yyods/TitraLab/MicroPython/Week_2/02_Pump_Control/README.md

# 02_Pump_Control - การควบคุมและสอบเทียบปั๊ม
# Pump Control and Calibration

---

> **ส่วนนี้เป็นส่วนของ:** Week 2 - TitraLab MicroPython
> **เวลาที่ใช้:** 45 นาที

---

## สารบัญ (Table of Contents)

| หมวด | เนื้อหา |
|:----:|---|
| 1 | [วัตถุประสงค์](#วัตถุประสงค์-objectives) |
| 2 | [ความรู้พื้นฐาน](#ความรู้พื้นฐาน-prerequisites) |
| 3 | [หลักการทางเคมี](#หลักการทางเคมี-chemistry-principles) |
| 4 | [ไฟล์ในโฟลเดอร์](#ไฟล์ในโฟลเดอร์-files-in-this-folder) |
| 5 | [รายละเอียดไฟล์](#รายละเอียดไฟล์-file-details) |
| 6 | [เคล็ดลับการปฏิบัติ](#เคล็ดลับการปฏิบัติ-practical-tips) |
| 7 | [GPIO Configuration](#gpio-configuration) |
| 8 | [การเชื่อมต่อบทถัดไป](#การเชื่อมต่อกับบทเรียนถัดไป-next-steps) |

---

## วัตถุประสงค์ (Objectives)

เมื่อจบบทเรียนนี้ นิสิตจะสามารถ:

1. **เข้าใจความสำคัญของการสอบเทียบปั๊ม** ต่อความแม่นยำในการไทเทรต
2. **คำนวณ Flow Rate** จากปริมาตรและเวลา: `flow_rate = volume / time`
3. **ประเมินความสม่ำเสมอ** ด้วย %RSD (Relative Standard Deviation)
4. **บันทึกค่า Flow Rate** ลงไฟล์สำหรับใช้ในการไทเทรต

---

## ความรู้พื้นฐาน (Prerequisites)

### จาก Week 1 - ต่อยอดจาก `Week_1/core/07_PWM/`

| ไฟล์ใน Week 1 | ความรู้ที่ใช้ใน Week 2 |
|---|---|
| `01_pwm_led_brightness.py` | Duty Cycle พื้นฐาน (0-1023) |
| `02_pwm_led_fade.py` | การเปลี่ยน Duty Cycle |
| `04_pwm_pump_preview.py` | การควบคุมปั๊มเบื้องต้น |

**การเชื่อมโยง PWM กับการควบคุมปั๊ม:**
```
Duty Cycle (0-1023) --> ความเร็วปั๊ม --> อัตราการไหล (mL/s) --> ปริมาตรสารไทแทรนต์
```

### ทางเคมี:
- หลักการไทเทรตและความสำคัญของปริมาตรที่แม่นยำ
- การใช้กระบอกตวง (graduated cylinder)

---

## หลักการทางเคมี (Chemistry Principles)

### ทำไมต้องสอบเทียบปั๊ม?

ในการไทเทรตอัตโนมัติ ปริมาตรสารไทแทรนต์ต้องแม่นยำมาก:

| ผลกระทบ | รายละเอียด |
|---|---|
| ความผิดพลาด 0.1 mL | อาจทำให้คำนวณความเข้มข้นผิดพลาด 1-2% |
| Flow rate ไม่แน่นอน | หาจุดสมมูล (equivalence point) ได้ยาก |
| ปั๊มแต่ละตัว | มี flow rate ไม่เท่ากัน - ต้องสอบเทียบทุกครั้ง |

### สูตรคำนวณ

```
Flow Rate (mL/s) = ปริมาตรที่วัดได้ (mL) / เวลา (s)
```

**ตัวอย่าง:**
- ปั๊ม 15 วินาที ได้ปริมาตร 4.2 mL
- Flow Rate = 4.2 / 15 = 0.28 mL/s

### การประเมินความสม่ำเสมอด้วย %RSD

```
%RSD = (Standard Deviation / Average) x 100
```

| %RSD | ความหมาย | สถานะ |
|:----:|---|:-----:|
| < 2% | ดีเยี่ยม | ผ่าน |
| 2-5% | พอใช้ได้ | ผ่าน |
| >= 5% | ไม่สม่ำเสมอ | ต้องตรวจสอบ |

---

## ไฟล์ในโฟลเดอร์ (Files in This Folder)

| ไฟล์ | คำอธิบาย | ระดับความสำคัญ | เวลา |
|---|---|:---:|:----:|
| `01_flow_rate_calibration.py` | **การสอบเทียบ Flow Rate** - ไฟล์หลักที่ต้องทำ | **สำคัญมาก** | 20 นาที |
| `02_pump_validate_continuous.py` | การตรวจสอบความแม่นยำ: ปั๊มต่อเนื่อง | ตรวจสอบ | 10 นาที |
| `03_pump_validate_stepwise.py` | การตรวจสอบความแม่นยำ: ปั๊มเป็นช่วง | เสริม | 10 นาที |

---

## รายละเอียดไฟล์ (File Details)

### 01_flow_rate_calibration.py

**วัตถุประสงค์:** หาอัตราการไหลที่แท้จริงของปั๊ม

**สิ่งที่เรียนรู้:**
- การใช้ PWM ควบคุมปั๊ม
- การวัด Flow Rate จากปริมาตรและเวลา
- การคำนวณค่าเฉลี่ย, SD, และ %RSD
- การบันทึกค่าสอบเทียบ

**แนวคิดจาก Week 1 ที่ใช้:**
| แนวคิด | ไฟล์อ้างอิงใน Week 1 |
|---|---|
| PWM Duty Cycle | `Week_1/core/07_PWM/01_pwm_led_brightness.py` |
| การควบคุมปั๊ม | `Week_1/core/07_PWM/04_pwm_pump_preview.py` |

**ขั้นตอนการทำงาน:**

```
┌─────────────────────────────────────────────────────────────────┐
│  ขั้นตอนการสอบเทียบ Flow Rate (Flow Rate Calibration Steps)     │
└─────────────────────────────────────────────────────────────────┘

    ┌─────────────────────┐
    │ 1. เตรียมกระบอกตวง   │
    │    และบีกเกอร์น้ำ     │
    └──────────┬──────────┘
               │
               v
    ┌─────────────────────┐
    │ 2. กดปุ่ม 1 เริ่มปั๊ม │
    │    (จับเวลาอัตโนมัติ)  │
    └──────────┬──────────┘
               │
               v
    ┌─────────────────────┐
    │ 3. ปั๊ม 10-20 วินาที │
    └──────────┬──────────┘
               │
               v
    ┌─────────────────────┐
    │ 4. กดปุ่ม 1 หยุดปั๊ม │
    │    แสดงเวลาที่ใช้     │
    └──────────┬──────────┘
               │
               v
    ┌─────────────────────┐
    │ 5. อ่านปริมาตรจาก    │
    │    กระบอกตวง         │
    │    แก้ไข MEASURED_   │
    │    VOLUME ในโค้ด     │
    └──────────┬──────────┘
               │
               v
    ┌─────────────────────┐
    │ 6. กดปุ่ม 2 บันทึก   │
    │    (ทำซ้ำ 3-5 ครั้ง)  │
    └──────────┬──────────┘
               │
               v
    ┌─────────────────────┐
    │ 7. กดปุ่ม 3 บันทึก   │
    │    ลงไฟล์            │
    │ flow_calibration.txt│
    └─────────────────────┘
```

**การควบคุมปุ่ม:**

| ปุ่ม | GPIO | การทำงาน |
|:----:|:----:|---|
| 1 | 34 | เริ่ม/หยุดปั๊ม |
| 2 | 35 | บันทึกปริมาตรที่วัดได้ |
| 3 | 39 | บันทึกลงไฟล์ |

**ผลลัพธ์:**
- ไฟล์ `/workspace/data/flow_calibration.txt` ที่มีค่า flow rate เฉลี่ย (mL/s)

**เกณฑ์ความสำเร็จ:**
- %RSD < 5%

**โค้ดสำคัญ - การคำนวณ Flow Rate และ %RSD:**

```python
def record_measurement():
    """
    บันทึกผลการวัดและคำนวณ flow rate
    สูตร: flow_rate = volume / time (mL/s)
    """
    global calibration_data, current_volume

    # ใช้ค่าจากตัวแปร MEASURED_VOLUME
    current_volume = MEASURED_VOLUME

    # คำนวณ flow rate
    flow_rate = current_volume / elapsed_time

    # บันทึกข้อมูล
    calibration_data.append((elapsed_time, current_volume, flow_rate))

    # คำนวณค่าเฉลี่ยและ RSD
    if len(calibration_data) >= 2:
        avg_flow_rate = sum(d[2] for d in calibration_data) / len(calibration_data)
        variance = sum((d[2] - avg_flow_rate) ** 2 for d in calibration_data) / len(calibration_data)
        std_dev = variance ** 0.5
        rsd = (std_dev / avg_flow_rate) * 100  # %RSD

        if rsd > 5:
            print("*** คำเตือน: RSD > 5% - ค่าไม่สม่ำเสมอ ***")
```

---

### 02_pump_validate_continuous.py

**วัตถุประสงค์:** ตรวจสอบความแม่นยำของการสอบเทียบด้วยการปั๊มต่อเนื่อง

**การใช้งาน:**
- ตั้งปริมาตรเป้าหมาย (เช่น 5 mL)
- ปั๊มจะหยุดเมื่อถึงปริมาตรที่ตั้งไว้
- วัดปริมาตรจริงจากกระบอกตวง
- เปรียบเทียบค่าที่วัดได้กับค่าที่ตั้งไว้

**การประยุกต์ใช้:**
- ใช้ในช่วงเริ่มต้นการไทเทรต (pH ยังห่างจากจุดสมมูล)

**เกณฑ์ความสำเร็จ:**
- % error < 5%

---

### 03_pump_validate_stepwise.py

**วัตถุประสงค์:** ตรวจสอบการปั๊มแบบเป็นช่วง (stepwise)

**การใช้งาน:**
- ปั๊มทีละ 0.1-0.5 mL
- หยุดรอให้ pH เสถียร
- ปั๊มต่อ

**การประยุกต์ใช้:**
- ใช้ในช่วงใกล้จุดสมมูล (equivalence point)
- ป้องกันการ overshoot จุดสมมูล

---

## เคล็ดลับการปฏิบัติ (Practical Tips)

### การเตรียมอุปกรณ์

1. ใช้กระบอกตวงที่มีความละเอียด 0.1 mL หรือดีกว่า
2. ตรวจสอบว่าท่อปั๊มไม่มีฟองอากาศ (purge ก่อนสอบเทียบ)
3. วางกระบอกตวงให้ตั้งตรง

### การวัด Flow Rate

1. ทำซ้ำ 3-5 ครั้งเพื่อหาค่าเฉลี่ย
2. ปั๊มครั้งละ 10-20 วินาทีเพื่อให้ได้ปริมาตรที่วัดง่าย
3. อ่านกระบอกตวงที่ระดับสายตา (meniscus)

### การแก้ไขเมื่อ %RSD >= 5%

| สาเหตุที่เป็นไปได้ | วิธีแก้ไข |
|---|---|
| ฟองอากาศในท่อ | Purge ท่อ (ปั๊มจนไม่มีฟอง) |
| ท่อหลวม | ตรวจสอบการเชื่อมต่อท่อ |
| แหล่งจ่ายไฟไม่เสถียร | ใช้แหล่งจ่ายไฟคุณภาพดี |
| จำนวนครั้งน้อย | เพิ่มจำนวนครั้งในการวัด |

---

## GPIO Configuration

| อุปกรณ์ | GPIO | ค่าคงที่ | ประเภท | หมายเหตุ |
|---|:----:|---|---|---|
| Pump | 21 | `PUMP_PIN` | PWM Output | freq=1000 Hz |
| Red LED (ปั๊มทำงาน) | 2 | `LED_RED` | Output | แสดงสถานะปั๊ม |
| Green LED (บันทึกสำเร็จ) | 4 | `LED_GREEN` | Output | แสดงการบันทึก |
| Button 1 (Start/Stop) | 34 | `BUTTON1` | Input-only | External pull-down |
| Button 2 (Record) | 35 | `BUTTON2` | Input-only | External pull-down |
| Button 3 (Save) | 39 | `BUTTON3` | Input-only | External pull-down |

### PWM Settings

```python
# ความถี่ 1000 Hz, Duty Cycle 10-bit (0-1023)
pump_pwm = PWM(Pin(21), freq=1000)
pump_pwm.duty(1023)  # Full speed
pump_pwm.duty(0)     # Stop
```

**การเชื่อมโยง Duty Cycle กับ Flow Rate:**

| Duty Cycle | ค่า | ความเร็วปั๊ม |
|:---:|:---:|:---:|
| 100% | 1023 | เต็มกำลัง |
| 50% | 511 | ครึ่งกำลัง |
| 0% | 0 | หยุด |

---

## การเชื่อมต่อกับบทเรียนถัดไป (Next Steps)

เมื่อสอบเทียบปั๊มสำเร็จแล้ว:

```
  ┌─────────────────────┐
  │ 01_pH_Sensor/       │
  │ (เสร็จแล้ว)          │ --> ph_calibration.txt
  └──────────┬──────────┘
             │
             v
  ┌─────────────────────┐
  │ 02_Pump_Control/    │     ไฟล์ที่ได้:
  │ (ปัจจุบัน)           │ --> flow_calibration.txt
  └──────────┬──────────┘
             │
             v
  ┌─────────────────────┐
  │ 03_OOP_Advanced/    │     เรียนรู้ OOP:
  │ (ถัดไปใน Week 2)    │     Inheritance,
  │                     │     Composition
  └──────────┬──────────┘
             │
             v
  ┌─────────────────────┐
  │ Week_3/             │     ใช้ค่าจากทั้งสองไฟล์
  │ ระบบไทเทรตอัตโนมัติ  │     ในการไทเทรตจริง
  └─────────────────────┘
```

1. **Week 2 ต่อ:** ไปที่ `../03_OOP_Advanced/` เพื่อเรียนรู้ OOP Concepts
2. **Week 3:** ใช้ค่าจาก `/workspace/data/flow_calibration.txt` ในระบบไทเทรตอัตโนมัติ

---

*สร้างเมื่อ: มกราคม 2026*
