yyods/TitraLab/MicroPython/Week_2/01_pH_Sensor/README.md

# 01_pH_Sensor - การวัดและสอบเทียบ pH
# pH Measurement and Calibration

---

> **ส่วนนี้เป็นส่วนของ:** Week 2 - TitraLab MicroPython
> **เวลาที่ใช้:** 60 นาที (1 ชั่วโมง)

---

## สารบัญ (Table of Contents)

| หมวด | เนื้อหา |
|:----:|---|
| 1 | [วัตถุประสงค์](#วัตถุประสงค์-objectives) |
| 2 | [ความรู้พื้นฐาน](#ความรู้พื้นฐาน-prerequisites) |
| 3 | [หลักการทางเคมี](#หลักการทางเคมี-chemistry-principles) |
| 4 | [ไฟล์ในโฟลเดอร์](#ไฟล์ในโฟลเดอร์-files-in-this-folder) |
| 5 | [รายละเอียดไฟล์](#รายละเอียดไฟล์-file-details) |
| 6 | [เคล็ดลับการปฏิบัติ](#เคล็ดลับการปฏิบัติ-practical-tips) |
| 7 | [GPIO Configuration](#gpio-configuration) |
| 8 | [การเชื่อมต่อบทถัดไป](#การเชื่อมต่อกับบทเรียนถัดไป-next-steps) |

---

## วัตถุประสงค์ (Objectives)

เมื่อจบบทเรียนนี้ นิสิตจะสามารถ:

1. **ทดสอบเวลาตอบสนองของหัววัด pH** (Response Time) โดยบันทึกค่า mV เมื่อย้ายระหว่างบัฟเฟอร์
2. **เข้าใจสมการ Nernst** และการแปลงค่า mV เป็น pH
3. **ทำการสอบเทียบ 3 จุด** ด้วยสารละลายบัฟเฟอร์มาตรฐาน (pH 4, 7, 10)
4. **คำนวณ Linear Regression ด้วยตัวเอง** จากข้อมูลดิบก่อนตรวจสอบกับโปรแกรม
5. **ประเมินคุณภาพการสอบเทียบ** ด้วย R-squared และ Slope Efficiency
6. **บันทึกค่าสอบเทียบ** ลงไฟล์สำหรับใช้ในการไทเทรต

---

## ความรู้พื้นฐาน (Prerequisites)

### จาก Week 1 - ต่อยอดจาก `Week_1/core/07_ADC/`

| ไฟล์ใน Week 1 | ความรู้ที่ใช้ใน Week 2 |
|---|---|
| `01_adc_basics.py` | การอ่านค่า ADC 12-bit (0-4095) |
| `02_adc_averaging.py` | การหาค่าเฉลี่ยเพื่อลด noise |
| `03_adc_attenuation.py` | การตั้งค่า ATTN_11DB สำหรับ 0-3.3V |

**การเชื่อมโยง ADC กับการวัด pH:**
```
หัววัด pH (mV) --> ADC (0-4095) --> แปลงเป็น mV --> สมการ Nernst --> ค่า pH
```

### ทางเคมี:
- หลักการทำงานของหัววัด pH (pH electrode)
- สมการ Nernst: E = E0 - (2.303RT/nF) x pH

---

## หลักการทางเคมี (Chemistry Principles)

### สมการ Nernst

หัววัด pH ให้สัญญาณแรงดันไฟฟ้า (mV) ตามสมการ:

```
E = E0 - (2.303RT/nF) x pH
```

จัดรูปใหม่เป็นสมการเส้นตรง:

```
E (mV) = m x pH + b
```

| ตัวแปร | ความหมาย | ค่าทฤษฎีที่ 25C |
|---|---|---|
| m (slope) | ความชัน | -59.16 mV/pH |
| b (intercept) | ศักย์ไฟฟ้าที่ pH=0 | ขึ้นกับหัววัด |

### ความชัน Nernst ที่อุณหภูมิต่างๆ

| อุณหภูมิ (C) | อุณหภูมิ (K) | ความชันทฤษฎี (mV/pH) |
|:---:|:---:|:---:|
| 20 | 293.15 | -58.17 |
| **25** | **298.15** | **-59.16** |
| 30 | 303.15 | -60.15 |

### การสอบเทียบ 3 จุด

| สารละลายบัฟเฟอร์ | ค่า pH | ความสำคัญ |
|:---:|:---:|---|
| Potassium hydrogen phthalate | 4.00 | ตัวแทนช่วงกรด (acidic range) |
| Phosphate buffer | 7.00 | จุด isopotential - ไม่ขึ้นกับอุณหภูมิ |
| Carbonate-bicarbonate buffer | 10.00 | ตัวแทนช่วงเบส (basic range) |

---

## ไฟล์ในโฟลเดอร์ (Files in This Folder)

| ไฟล์ | คำอธิบาย | ระดับความสำคัญ | เวลา |
|---|---|:---:|:----:|
| `01_basic_ph_read.py` | **ทดสอบ Response Time** - บันทึก mV ทุกวินาทีเป็นเวลา 45 วินาที | ทำความเข้าใจ | 15-20 นาที |
| `02_calibration_3point.py` | **การสอบเทียบ pH 3 จุด** - ไฟล์หลักที่ต้องทำ พร้อมแสดงข้อมูลดิบสำหรับคำนวณเอง | **สำคัญมาก** | 40 นาที |

---

## รายละเอียดไฟล์ (File Details)

### 01_basic_ph_read.py

**วัตถุประสงค์:** ทดสอบเวลาตอบสนอง (Response Time) ของหัววัด pH

**การทดลอง:**
1. แช่หัววัด pH ในสารละลายบัฟเฟอร์
2. กดปุ่มเพื่อเริ่มบันทึก
3. โปรแกรมจะบันทึกค่า mV ทุก 1 วินาที เป็นเวลา 45 วินาที
4. นำข้อมูลไปวิเคราะห์ดูว่าหัววัดเสถียรที่เวลาเท่าไร

**สิ่งที่เรียนรู้:**
- การใช้ ADC อ่านค่าจากหัววัด pH (GPIO32)
- การอ่านอุณหภูมิจาก DS18B20 (GPIO16)
- การแปลงค่า ADC เป็น mV: `voltage_mv = adc_value * 3300 / 4095`
- วงจร op-amp (LMC6482) ชดเชย offset +1650 mV
- การแสดงผลบนจอ TFT

**แนวคิดจาก Week 1 ที่ใช้:**
| แนวคิด | ไฟล์อ้างอิงใน Week 1 |
|---|---|
| ADC 12-bit | `Week_1/core/07_ADC/01_adc_basics.py` |
| การหาค่าเฉลี่ย | `Week_1/core/07_ADC/02_adc_averaging.py` |
| TFT Display | `Week_1/05_TFT/` |

---

### 02_calibration_3point.py

**วัตถุประสงค์:** สอบเทียบหัววัด pH ด้วยสารละลายบัฟเฟอร์มาตรฐาน 3 จุด

**สิ่งที่เรียนรู้:**
- การสอบเทียบ 3 จุด (3-point calibration)
- การคำนวณ Linear Regression ด้วยตัวเอง (ก่อนตรวจสอบกับโปรแกรม)
- การประเมิน R-squared และ Slope Efficiency
- การบันทึกค่าสอบเทียบ

**คุณสมบัติใหม่ - แสดงข้อมูลดิบสำหรับคำนวณเอง:**

หลังจากสอบเทียบครบ 3 จุด โปรแกรมจะแสดงตารางข้อมูลดิบ:
```
╔══════════════════════════════════════════════════╗
║     RAW CALIBRATION DATA FOR MANUAL CALCULATION  ║
║     ข้อมูลดิบสำหรับคำนวณด้วยตนเอง                  ║
╠══════════════════════════════════════════════════╣
║  Point  │  pH (x)  │   mV (y)   │  Temp (°C)    ║
║─────────┼──────────┼────────────┼───────────────║
║    1    │   4.00   │  1827.5    │    25.2       ║
║    2    │   7.00   │  1650.3    │    25.1       ║
║    3    │  10.00   │  1473.1    │    25.3       ║
╚══════════════════════════════════════════════════╝
```

พร้อมแสดงสูตรสำหรับการคำนวณ Linear Regression:
- slope (m) = (n·Σxy - Σx·Σy) / (n·Σx² - (Σx)²)
- intercept (b) = (Σy - m·Σx) / n
- R² = 1 - SS_res/SS_tot

นิสิตจะมีเวลาคำนวณด้วยตัวเองก่อนกดปุ่มดูคำตอบจากโปรแกรม

**ขั้นตอนการทำงาน:**

```
┌─────────────────────────────────────────────────────────────────┐
│  ขั้นตอนการสอบเทียบ pH 3 จุด (3-Point pH Calibration Steps)    │
└─────────────────────────────────────────────────────────────────┘

    ┌─────────────────────┐
    │ 1. แช่ใน pH 4.00    │
    │    รอเสถียร 30-60s   │
    │    กดปุ่มบันทึก       │
    └──────────┬──────────┘
               │
               v
    ┌─────────────────────┐
    │ 2. ล้างหัววัด        │
    │    แช่ใน pH 7.00    │
    │    รอเสถียร 30-60s   │
    │    กดปุ่มบันทึก       │
    └──────────┬──────────┘
               │
               v
    ┌─────────────────────┐
    │ 3. ล้างหัววัด        │
    │    แช่ใน pH 10.00   │
    │    รอเสถียร 30-60s   │
    │    กดปุ่มบันทึก       │
    └──────────┬──────────┘
               │
               v
    ┌─────────────────────┐
    │ 4. คำนวณ Linear     │
    │    Regression       │
    │    แสดงผล R^2       │
    └──────────┬──────────┘
               │
               v
    ┌─────────────────────┐
    │ 5. บันทึกไฟล์        │
    │    ph_calibration   │
    │    .txt             │
    └─────────────────────┘
```

**ผลลัพธ์:**
- ไฟล์ `/workspace/data/ph_calibration.txt` ที่มี slope, intercept, R-squared, อุณหภูมิ
- ไฟล์ `calibration_log.txt` รายละเอียดการสอบเทียบ

**เกณฑ์ความสำเร็จ:**

| ตัวชี้วัด | ดีเยี่ยม | พอใช้ได้ | ต้องทำใหม่ |
|---|:---:|:---:|:---:|
| R-squared | >= 0.999 | >= 0.99 | < 0.99 |
| Slope Efficiency | 95-105% | 90-110% | นอกช่วงนี้ |

**โค้ดสำคัญ - การคำนวณ Linear Regression:**

```python
def linear_regression(x_values, y_values):
    """
    คำนวณการถดถอยเชิงเส้น y = mx + b พร้อมค่า R-squared
    สำหรับเซ็นเซอร์ pH: E(mV) = m * pH + b
    """
    n = len(x_values)

    # คำนวณค่าที่ต้องใช้ (Calculate required sums)
    sum_x = sum(x_values)
    sum_y = sum(y_values)
    sum_xy = sum(x * y for x, y in zip(x_values, y_values))
    sum_x2 = sum(x ** 2 for x in x_values)

    # คำนวณความชัน (Calculate slope)
    denominator = n * sum_x2 - sum_x ** 2
    slope = (n * sum_xy - sum_x * sum_y) / denominator

    # คำนวณจุดตัดแกน y (Calculate intercept)
    intercept = (sum_y - slope * sum_x) / n

    # คำนวณ R-squared
    y_mean = sum_y / n
    ss_tot = sum((y - y_mean) ** 2 for y in y_values)
    ss_res = sum((y - (slope * x + intercept)) ** 2
                 for x, y in zip(x_values, y_values))
    r_squared = 1 - (ss_res / ss_tot)

    return slope, intercept, r_squared
```

---

## เคล็ดลับการปฏิบัติ (Practical Tips)

### การเตรียมสารละลายบัฟเฟอร์

1. ใช้สารละลายบัฟเฟอร์มาตรฐานที่ยังไม่หมดอายุ
2. เก็บรักษาในภาชนะที่ปิดสนิท ห่างจากความร้อนและแสง
3. ตรวจสอบอุณหภูมิของสารละลายบัฟเฟอร์

### การล้างหัววัด

1. ล้างด้วยน้ำกลั่น (deionized water) ระหว่างเปลี่ยนบัฟเฟอร์
2. ซับน้ำเบาๆ ด้วยกระดาษทิชชู่ - ห้ามถูแรง
3. ไม่ควรปล่อยให้หัววัดแห้ง

### เวลารอให้ค่าเสถียร (Stabilization Time)

- รอ 30-60 วินาทีหลังจากแช่หัววัดในบัฟเฟอร์
- ค่าควรเปลี่ยนแปลงน้อยกว่า 1 mV/นาที ก่อนกดบันทึก

### การแก้ไขเมื่อ R-squared < 0.99

| สาเหตุที่เป็นไปได้ | วิธีแก้ไข |
|---|---|
| สารละลายบัฟเฟอร์เสื่อมสภาพ | ใช้บัฟเฟอร์ใหม่ |
| หัววัดสกปรก | ทำความสะอาดหัววัด |
| สายสัญญาณหลวม | ตรวจสอบการเชื่อมต่อ |
| ไม่รอให้เสถียร | รอนานขึ้นก่อนกดบันทึก |

---

## GPIO Configuration

| อุปกรณ์ | GPIO | ค่าคงที่ | ประเภท | หมายเหตุ |
|---|:----:|---|---|---|
| pH Sensor | 32 | `MY_PH_PIN` | ADC Input (ADC1) | ATTN_11DB (0-3.3V), ใช้ได้กับ WiFi |
| Temperature (DS18B20) | 16 | `MY_TEMP_PIN` | OneWire | ต้องใช้ pull-up 4.7K |
| Button 1 (บันทึก) | 34 | `MY_BUTTON_PIN` | Input-only | ต้องใช้ external pull-down |
| TFT Display | SPI1 | - | SPI | GPIO14 SCK, GPIO13 MOSI |

---

## การเชื่อมต่อกับบทเรียนถัดไป (Next Steps)

เมื่อสอบเทียบ pH สำเร็จแล้ว:

```
  ┌─────────────────────┐
  │ 01_pH_Sensor/       │     ไฟล์ที่ได้:
  │ (ปัจจุบัน)           │ --> ph_calibration.txt
  └──────────┬──────────┘
             │
             v
  ┌─────────────────────┐
  │ 02_Pump_Control/    │     สอบเทียบ Flow Rate
  │ (ถัดไปใน Week 2)    │ --> flow_calibration.txt
  └──────────┬──────────┘
             │
             v
  ┌─────────────────────┐
  │ Week_3/             │     ใช้ค่าจากทั้งสองไฟล์
  │ ระบบไทเทรตอัตโนมัติ  │     ในการไทเทรตจริง
  └─────────────────────┘
```

1. **Week 2 ต่อ:** ไปที่ `../02_Pump_Control/` เพื่อสอบเทียบปั๊ม
2. **Week 3:** ใช้ค่าจาก `/workspace/data/ph_calibration.txt` ในระบบไทเทรตอัตโนมัติ

---

*สร้างเมื่อ: มกราคม 2026*
