yyods/TitraLab/imgs/1.png

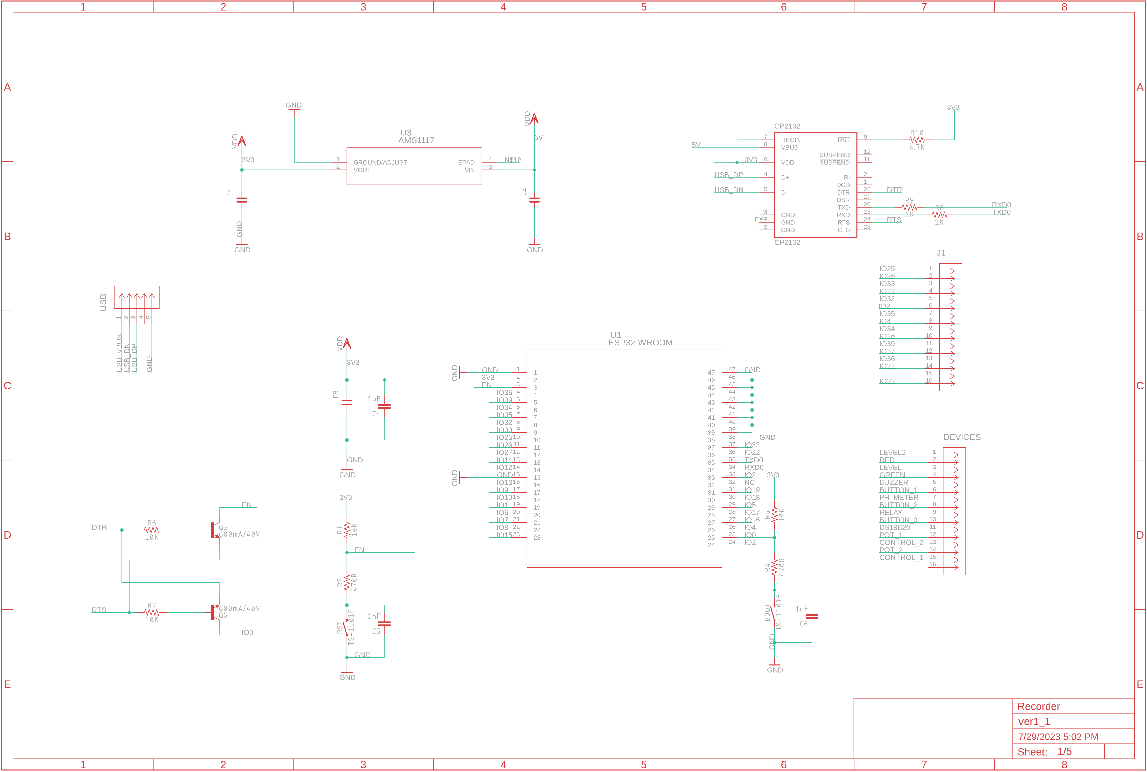
imgs/1.png
