yyods/TitraLab/imgs/2.png

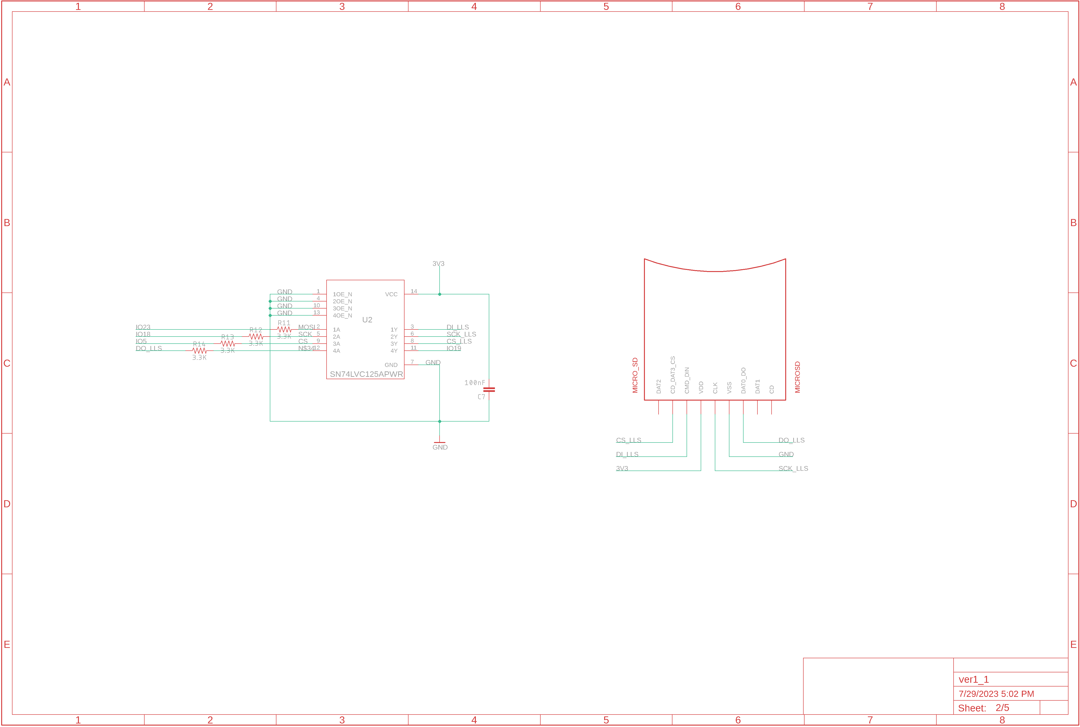
imgs/2.png
