yyods/TitraLab/imgs/3.png

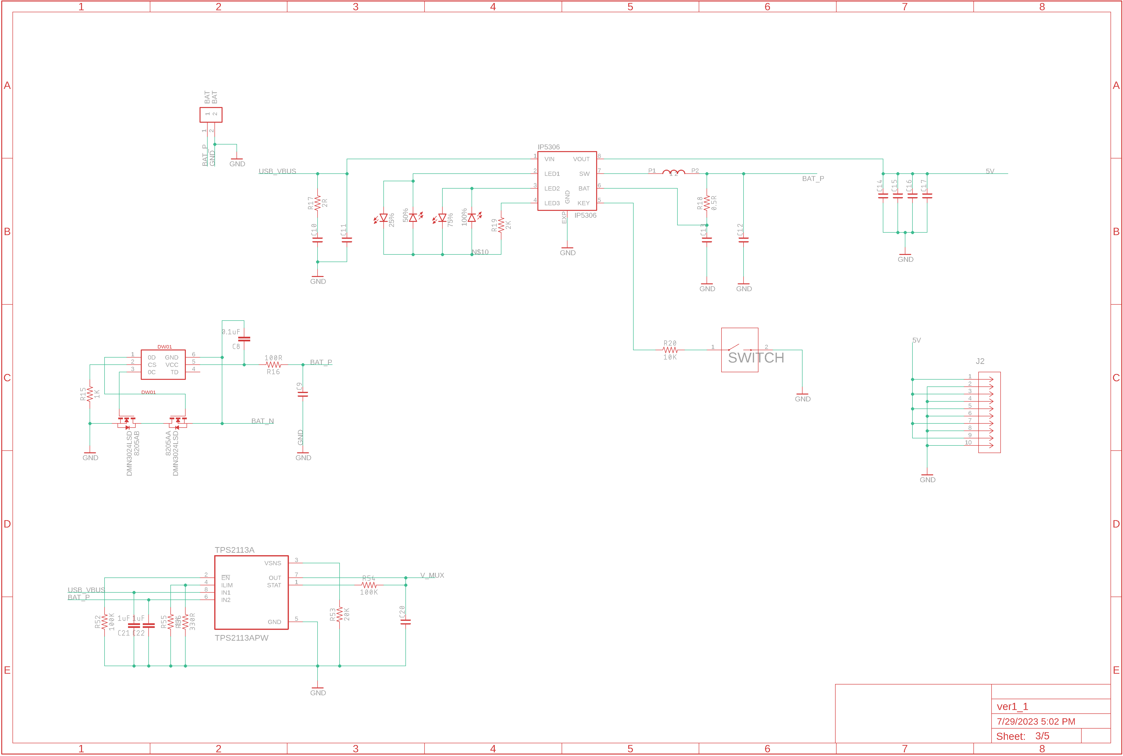
imgs/3.png
