yyods/TitraLab/imgs/4.png

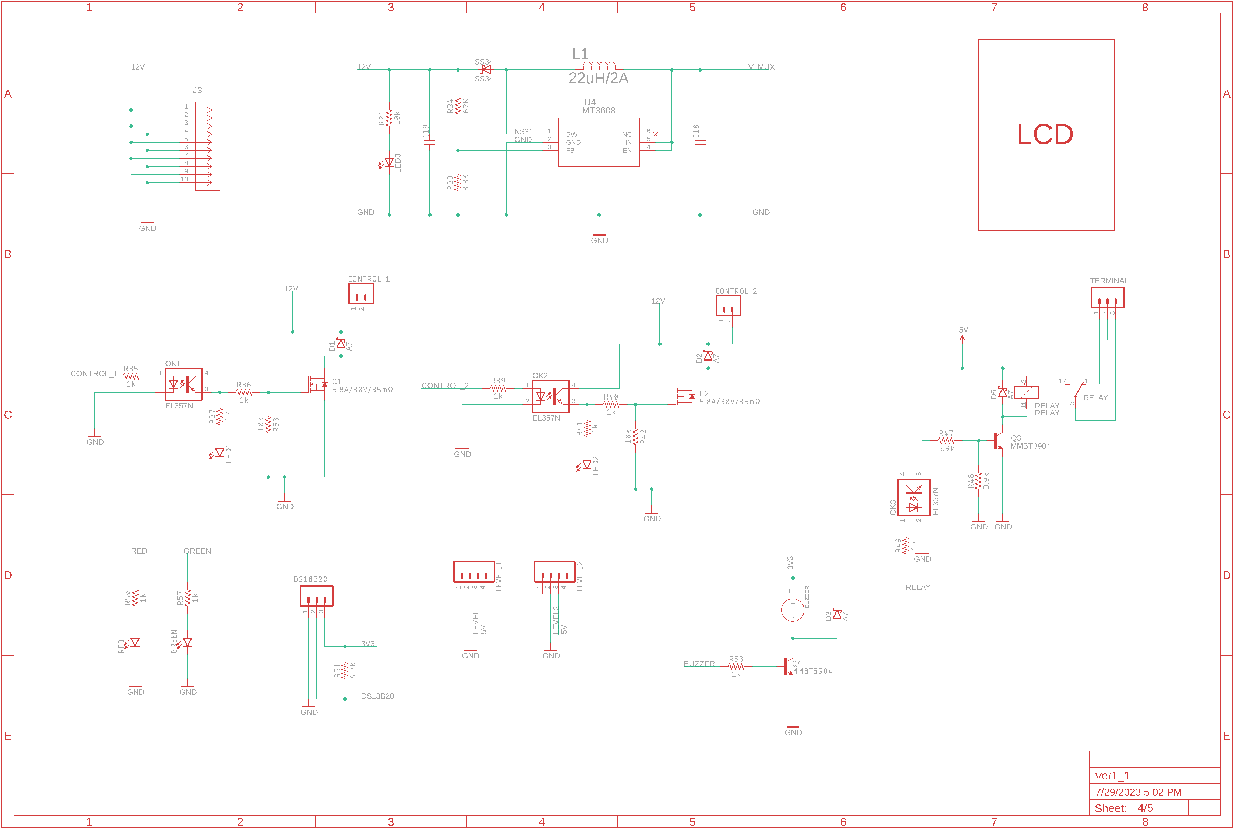
imgs/4.png
