yyods/TitraLab/imgs/5.png

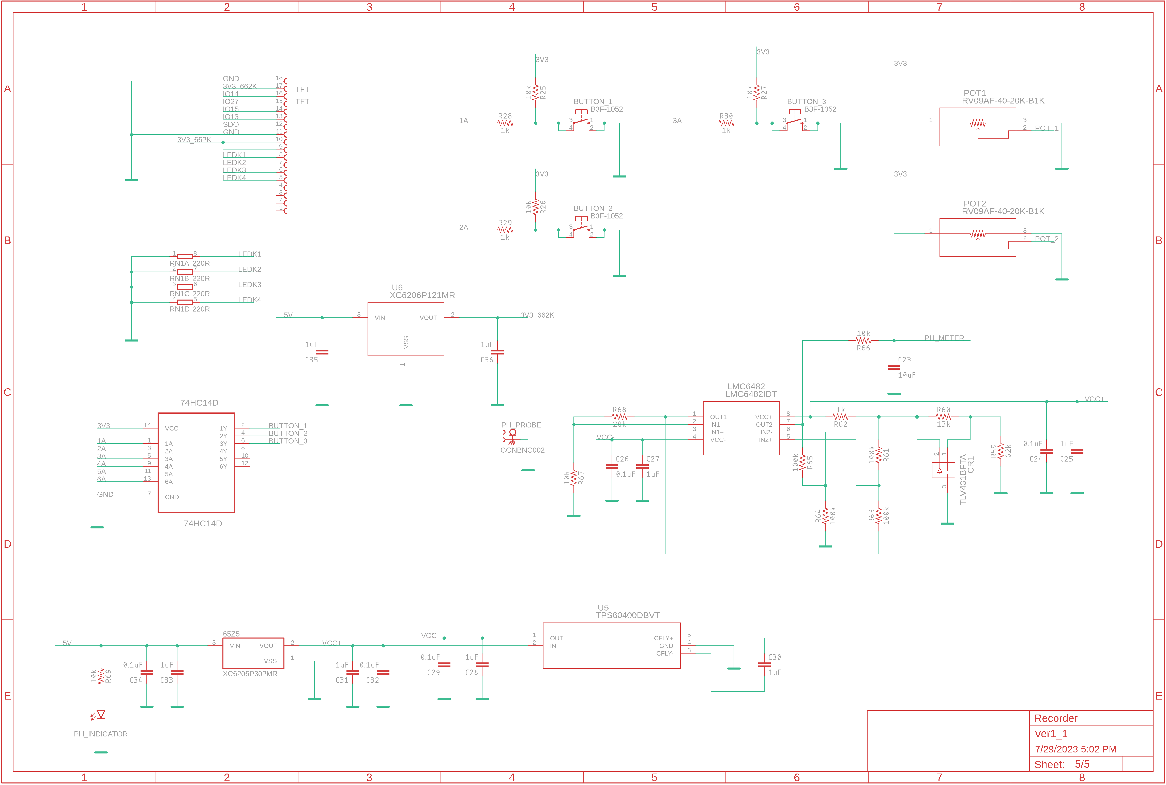
imgs/5.png
