yyods/TitraLab/imgs/ver1_1_Bottom.png

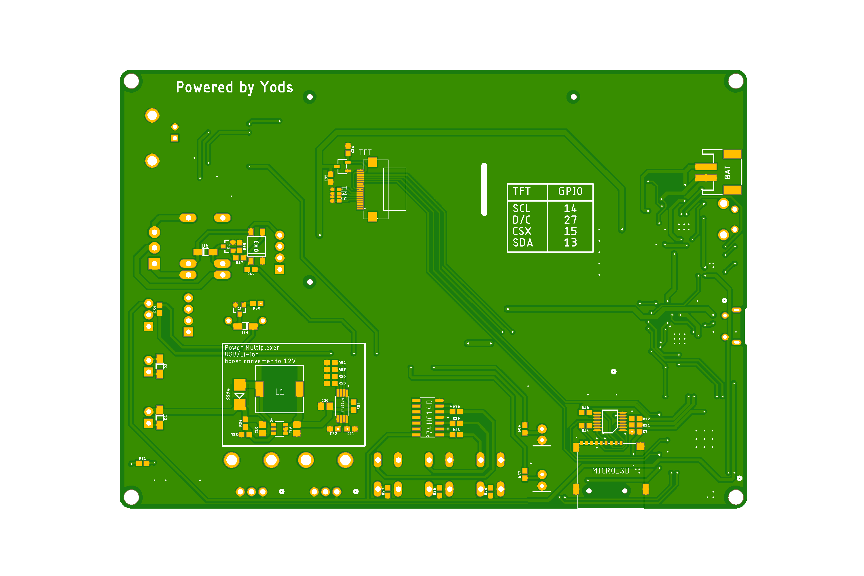
imgs/ver1_1_Bottom.png
