yyods/TitraLab/EquivPoint/test_wrong_columns.csv

Volume | pH
1.0 | 7.0
