yyods/TitraLab/MicroPython/Week_2/02_Pump_Control/04_flow_stepwise_finetune.py

# ==============================================================================
# 04_flow_stepwise_finetune.py - ปรับละเอียดอัตราการไหลแบบ stop-flow
# Stepwise (stop-flow) fine-tune for the pump calibration
# ==============================================================================
# ทำไมต้องมีขั้นนี้ (Why this stage exists):
#   การสอบเทียบใน 01_flow_rate_calibration.py วัดอัตราการไหลแบบ "ไหลต่อเนื่อง"
#   แต่การไทเทรตจริง (Week_3) หยดแบบ "หยุด-ไหล" (stop-flow) เป็นช่วงสั้น ๆ
#   ทุกครั้งที่ปั๊มสตาร์ท จะมีช่วง "เสียเปล่า" (มอเตอร์หมุนขึ้น, ท่อยืดหยุ่น,
#   soft-start ของเฟิร์มแวร์) ทำให้แต่ละหยดจ่ายน้อยกว่าที่คำนวณ — สะสมทั้งการ
#   ไทเทรตอาจคลาดถึง ~0.4 mL ซึ่งยอมรับไม่ได้ในเคมีวิเคราะห์
#
#   Continuous calibration amortizes the START-UP DEFICIT (motor spin-up,
#   tubing elasticity, firmware soft-start) over one long run. Stop-flow
#   dosing pays that deficit ON EVERY BURST. This lesson MEASURES it:
#
#       V(t_on) = flow_ss x t_on - V_deficit          (two-parameter pump model)
#
#   ขั้นตอน: หยด N ครั้งด้วยโปรไฟล์เดียวกับการไทเทรตจริง -> นิสิตอ่านปริมาตร
#   จริงจากกระบอกตวง -> คำนวณ V_deficit ต่อหยด -> บันทึกเพิ่มในไฟล์สอบเทียบ
#   (burst_deficit_ml) — Week_3 จะชดเชยเวลาเปิดปั๊มให้อัตโนมัติ
#
# ลำดับบทเรียน (Lesson order):
#   01_flow_rate_calibration.py  -> flow_rate (ไหลต่อเนื่อง)
#   04_flow_stepwise_finetune.py -> burst_deficit_ml (ไฟล์นี้)
#   03_pump_validate_stepwise.py -> ตรวจสอบว่า stop-flow ตรงเป้าแล้ว
#
# สำคัญ: บทเรียนนี้ขับปั๊มผ่าน slp.set_actuator (เส้นทางเดียวกับการไทเทรต
# Week_3 รวม soft-start ของเฟิร์มแวร์) — ไม่ใช่ PWM ตรงแบบ 01/02/03 — เพื่อวัด
# ช่วงเสียเปล่าของ "ระบอบการทำงานจริง" (calibrate in the regime you operate!)
# ต่อแบตเตอรี่ก่อนใช้ปั๊มเสมอ (Battery required for the pump.)
# ==============================================================================

import time

import scilabpro as slp

# ==============================================================================
# ค่าคงที่ (Constants)
# ==============================================================================
CAL_PATH = '/workspace/data/flow_calibration.txt'
PUMP_ENDPOINT = 'CONTROL_1'
DOSE_VOLUME_ML = 0.2      # ปริมาตรต่อหยดเหมือน Week_3 (same as the titration)
N_BURSTS = 25             # จำนวนหยด -> คาดหวังรวม 5.0 mL (expected 5.0 mL)
PAUSE_MS = 1500           # หยุดระหว่างหยด (pause between bursts)
MAX_ON_MS = 1800          # เพดานความปลอดภัยต่อหยด (per-burst safety ceiling)


def load_flow_rate():
    """อ่าน flow_rate จากไฟล์สอบเทียบขั้นที่ 1 (ต้องทำ 01 ก่อน)."""
    try:
        with open(CAL_PATH, 'r') as f:
            for line in f:
                line = line.strip()
                if line.startswith('flow_rate='):
                    return float(line.split('=')[1])
    except OSError:
        pass
    return None


def save_deficit(flow_rate, deficit_ml, dead_time_ms):
    """เขียน burst_deficit_ml เพิ่มในไฟล์สอบเทียบ (คงค่า flow_rate เดิมไว้).

    รูปแบบไฟล์ยังเข้ากันได้ย้อนหลัง: ผู้อ่านเดิมที่รู้จักแค่ flow_rate=
    ยังใช้งานได้ (additive key, backward compatible).
    """
    lines = []
    try:
        with open(CAL_PATH, 'r') as f:
            for line in f:
                # ตัดค่า deficit เก่าออก (จะเขียนใหม่ด้านล่าง)
                if not line.strip().startswith('burst_deficit_ml='):
                    lines.append(line.rstrip('\n'))
    except OSError:
        lines = [f'flow_rate={flow_rate:.4f}']
    lines.append('# stop-flow fine-tune (04): per-burst start-up deficit')
    lines.append(f'# dead_time ~ {dead_time_ms:.0f} ms/burst at this flow rate')
    lines.append(f'burst_deficit_ml={deficit_ml:.4f}')
    with open(CAL_PATH, 'w') as f:
        f.write('\n'.join(lines) + '\n')
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
