yyods/TitraLab/(commit log)

2023-08-28 Please enter the commit message for your changes. Lines starting with '#' will be ignored, and an empty message aborts the commit.
    On branch main
    Your branch is up to date with 'origin/main'.
    Changes to be committed:
    new file: ArduinoIDE/001/001.ino
    new file: ArduinoIDE/001/debug.cfg
    new file: ArduinoIDE/001/debug_custom.json
    new file: ArduinoIDE/001/esp32.svd
    new file: ArduinoIDE/002/002.ino
    new file: ArduinoIDE/002/debug.cfg
    new file: ArduinoIDE/002/debug_custom.json
    new file: ArduinoIDE/002/esp32.svd
    new file: ArduinoIDE/Buzzer/01/01.ino
    new file: ArduinoIDE/Buzzer/01/pitches.h
    new file: ArduinoIDE/Buzzer/02/02.ino
    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
    [001.ino, 002.ino, 01.ino, 02.ino, 03.ino, 04.ino, pitches.h]
2023-08-28 Please enter the commit message for your changes. Lines starting with '#' will be ignored, and an empty message aborts the commit.
    new file: .gitignore
    deleted: ArduinoIDE/001/001.ino
    deleted: ArduinoIDE/001/debug.cfg
    deleted: ArduinoIDE/001/debug_custom.json
    deleted: ArduinoIDE/001/esp32.svd
    deleted: ArduinoIDE/002/002.ino
    deleted: ArduinoIDE/002/debug.cfg
    deleted: ArduinoIDE/002/debug_custom.json
    deleted: ArduinoIDE/002/esp32.svd
    deleted: ArduinoIDE/Buzzer/01/01.ino
    deleted: ArduinoIDE/Buzzer/01/pitches.h
    deleted: ArduinoIDE/Buzzer/02/02.ino
    deleted: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
    [001.ino, 002.ino, 01.ino, 02.ino, 03.ino, 04.ino, pitches.h]
2023-08-28 Please enter the commit message for your changes. Lines starting with '#' will be ignored, and an empty message aborts the commit.
    new file: ArduinoIDE/Buzzer/02/pitches.h
    new file: ArduinoIDE/Buzzer/03/03.ino
    new file: ArduinoIDE/Buzzer/03/pitches.h
    new file: ArduinoIDE/Buzzer/04/04.ino
    new file: ArduinoIDE/Buzzer/04/pitches.h
    new file: ArduinoIDE/Show/01/01.ino
    new file: ArduinoIDE/Sho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
    [001.ino, 002.ino, 01.ino, 02.ino, 03.ino, 04.ino, pitches.h]
2024-01-15 Please enter the commit message for your changes. Lines starting with '#' will be ignored, and an empty message aborts the commit.
    new file: MicroPython/2023/1.py
    new file: MicroPython/2023/2.py
    new file: MicroPython/2023/ArcadePix9x11.c
    new file: MicroPython/2023/EspressoDolce18x24.c
    new file: MicroPython/2023/boot.py
    new file: MicroPython/2023/data.csv
    new file: MicroPython/2023/data2.csv
    new file: MicroPython/2023/ili9341.py
    new file: MicroPython/2023/lib/_boot.pyi
    new file: MicroPython/2023/lib/_onewire.pyi
    new file: MicroPython/2023/lib/_thread.pyi
    new file: Mic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
    [data.csv, data2.csv]
2024-01-15 Please enter the commit message for your changes. Lines starting with '#' will be ignored, and an empty message aborts the commit.
    Your branch is ahead of 'origin/main' by 1 commit.
    (use "git push" to publish your local commits)
    deleted: MicroPython/2023/1.py
    deleted: MicroPython/2023/2.py
    deleted: MicroPython/2023/ArcadePix9x11.c
    deleted: MicroPython/2023/EspressoDolce18x24.c
    deleted: MicroPython/2023/boot.py
    deleted: MicroPython/2023/data.csv
    deleted: MicroPython/2023/data2.csv
    deleted: MicroPython/2023/ili9341.py
    deleted: MicroPython/2023/lib/_boot.pyi
    deleted: MicroPython/2023/lib/_onewire.pyi
    delete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
    [data.csv, data2.csv]
2024-01-23 Please enter the commit message for your changes. Lines starting with '#' will be ignored, and an empty message aborts the commit.
    new file: MicroPython/Calibrations/cal_flowrate.py
    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
2024-01-24 Please enter the commit message for your changes. Lines starting with '#' will be ignored, and an empty message aborts the commit.
    new file: MicroPython/Calibrations/cal_pH.py
    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
2024-02-19 Please enter the commit message for your changes. Lines starting with '#' will be ignored, and an empty message aborts the commit.
    new file: EquivPoint/README.md
    new file: EquivPoint/data.csv
    new file: EquivPoint/data.png
    new file: EquivPoint/equiv_point.py
    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
    [data.csv]
2025-01-17 Please enter the commit message for your changes. Lines starting with '#' will be ignored, and an empty message aborts the commit.
    new file: .DS_Store
    new file: Documents/Prelab_Week2.pdf
    new file: Documents/Report_Week2.docx
    new file: MicroPython/.DS_Store
    new file: MicroPython/Week_2/.DS_Store
    renamed: MicroPython/Week_2/cal_flowrate.py -> MicroPython/Week_2/Old/cal_flowrate.py
    renamed: MicroPython/Week_2/cal_pH.py -> MicroPython/Week_2/Old/cal_pH.py
    new file: MicroPython/Week_2/Pump/01_flowRate.py
    new file: MicroPython/Week_2/Pump/flow_nonstop.py
    new file: MicroPython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
2025-04-08 Please enter the commit message for your changes. Lines starting with '#' will be ignored, and an empty message aborts the commit.
    modified: .DS_Store
    modified: EquivPoint/equiv_point.py
    new file: EquivPoint/titration_data_R1.csv
    renamed: MicroPython/Week_2/Pump/flow_nonstop.py -> MicroPython/Week_2/Pump/pumpValidate_1.py
    renamed: MicroPython/Week_2/Pump/flow_stop2.py -> MicroPython/Week_2/Pump/pumpValidate_2.py
    modified: MicroPython/Week_2/pH/01_pH.py
    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
    [titration_data_R1.csv]
2026-01-09 Update Week_2 MicroPython examples (pH, Pump, calibration)
2026-01-09 Add ADC, PWM, DAC examples and update Week_1/Week_2 content
2026-01-09 Restructure Week_2: organize into pH_Sensor, Pump_Control, OOP_Advanced folders
2026-01-10 Restructure Week_1 core: reorder lessons for better progression (LED, Button, ADC/pH, PWM/Pump, Display, OOP)
2026-01-10 Update EquivPoint analysis, Week_2/Week_3 improvements, and documentation
    [data.csv, test_wrong_columns.csv]
2026-01-19 Update pH sensor calibration code
2026-01-19 Update pH sensor and OOP examples
2026-01-19 Update pH sensor README documentation
2026-01-24 Update Week_2 pH sensor and pump control examples
2026-01-25 Update Week_3 pump control and documentation
2026-01-26 Update Week_3 documentation, config, and pH sensor module
2026-01-26 Update Week_3 titration logic and pH sensor handling
2026-02-02 Week 3: Update titration core, calibrator, display, and documentation
2026-05-04 Update MicroPython weeks 1-3, ArduinoIDE examples, EquivPoint, and docs
    [test_wrong_columns.csv, titration_data_R1.csv]
2026-06-01 Week_2 Lane B: actuator-safety ruling R for pump/buzzer teaching scripts
    Decision 0027 (Micropad, architect-frozen) Lane B — safety-hw ruling.
    Ruling: Option R (raw machine.PWM + mandated safeguards). Rationale: the
    firmware F-40 actuator-guard GPTimer arms ONLY via the on/off+max_on_ms
    guarded path (scilabpro.set_actuator); it has NO duty-cycle API, so routing
    the duty→flow-rate pump curriculum through it (Option G) would destroy the
    core teaching. Run-scoped TWDT is DISABLED on 0.3.x (dec 0026/F-156), so a
    wedged raw-PWM script has no firmware force-cut — accepted as a documented
    v1 limitation for these supervised physical-access Thonny scripts. No new
    firmware helper needed (duty-a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
    [01_flow_rate_calibration.py, 02_composition_pump.py, 02_pump_validate_continuous.py, 03_pump_validate_stepwise.py, 04_combined_demo.py, 05_class_static_methods.py]
2026-06-01 Week_2 Lane A: release_tft + stop_requested for pH/sensor scripts; pH ADC2->ADC1 fix
    Fixes 'OSError: SPI host already in use' in pH-sensor scripts that init SPI(1)
    for the TFT while the firmware owns the ILI9341 SPI host at boot. Adds the
    F-147 scilabpro.release_tft() guard before SPI(1,...) and cooperative
    stop_requested() polling in long loops (mirrors Week_1 core/07,09).
    Also corrects PH_PIN 25 (ADC2, Wi-Fi conflict) -> 32 (ADC1) in pins.py,
    lib/ph_sensor.py, and the OOP_Advanced PHSensor demos. Per decision 0027.
    [01_basic_ph_read.py, 01_inheritance_sensors.py, 02_calibration_3point.py, 03_property_decorator.py, pins.py]
2026-06-01 Week_2: fix TFT layout geometry in 01_basic_ph_read.py (follow-up to 0ab97e5, decision 0027)
    The release_tft() fix (0ab97e5) let the script run past the SPI(1,...) crash,
    exposing a pre-existing TFT drawing-geometry bug: the Display was declared
    portrait (width=240, height=320) while the whole layout was written for the
    Week_1 landscape convention (center x=160 => needs 320 wide; y up to 260 =>
    needs 320 tall). On the rdagger ili9341 driver, width/height are the logical
    coordinate space (rotation only sets MADCTL, it does NOT swap axes), so x=244,
    309 and y=260 overflowed the 240/320 declared bounds.
    Fix (geometry/layout only, teaching content + CSV logic preserved):
    - Declare landscape 320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
    [01_basic_ph_read.py]
2026-06-01 Week_2/01_pH: fix board hang at 45/45 — defer unsafe stop to main loop
    Root cause: record_data_callback (Timer(0) PERIODIC, scheduled/soft-IRQ
    context) called stop_recording() at t=45, which did timer.deinit() ON THE
    RUNNING CALLBACK'S OWN TIMER plus save_data_to_csv() flash file I/O — both
    unsafe from callback context, wedging the board. button_callback (Pin.irq)
    had the same anti-pattern: start/stop (timer create/deinit + file I/O)
    directly from IRQ context.
    Fix (preserves decision 0027 Timer pedagogy — callbacks->flags->main-loop
    is a correctness fix, not a teaching-point change):
    - record_data_callback: keep per-second sampling/TFT/print (proven safe in
    callback context); at t>=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
    [01_basic_ph_read.py]
2026-06-01 Week_2/01_pH_Sensor: fix MemoryError compiling ili9341 driver
    02_calibration_3point.py raised "MemoryError: memory allocation failed,
    allocating 136 bytes" at "from ili9341 import Display, color565" (line 106).
    Root cause: 02 imported the small xglcd_font (~6.8KB) BEFORE the large
    ili9341 (~37KB, single Display class, 37 methods). The first import
    fragments the heap; the importer then cannot find a contiguous block to
    compile ili9341 source -> bytecode, so even a tiny 136-byte alloc fails.
    01_basic_ph_read.py imports ili9341 FIRST, so it never hit this.
    Fix (script-side, no firmware/spec change):
    - 02: import ili9341 BEFORE xglcd_font (match 01); add gc.collect()
    before each heavy compile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
    [01_basic_ph_read.py, 02_calibration_3point.py]
2026-06-01 fix(week2/ph): reduce ili9341 clear() buffer to hlines=2 + gc.collect on heap-tight board
    02_calibration_3point.py reached calibrate_pH() then hit MemoryError on the
    5120 B clear buffer (ili9341.clear default hlines=8 -> 320*2*8). 02 is heavier
    than 01 (adds onewire/ds18x20, ~1052-line script) so free heap is genuinely
    tight by the time the drivers are resident.
    - All three display.clear() calls (display_raw_calibration_data,
    display_results, calibrate_pH loop) now pass hlines=2 -> 1280 B, a safe
    factor of both 240 and 320.
    - gc.collect() added immediately before each clear-then-draw block so the
    buffer alloc runs against a coalesced heap.
    - 01_basic_ph_read.py given the same prophyla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
    [01_basic_ph_read.py, 02_calibration_3point.py]
2026-06-01 fix(week2/ph): reduce ili9341 clear() buffer on remaining 3 calls (926/965/1094)
    Follow-up to 55a3479, which fixed 3 of 6 clear() sites but missed the
    three in the live per-point calibration loop and finally-cleanup. Those
    still allocated the default hlines=8 (5120 B) and hit MemoryError on the
    heap-tight board immediately after the fixed 848 clear.
    Apply same treatment to measuring/recorded/cleanup clears: gc.collect()
    + display.clear(hlines=2) (1280 B). All six clear() sites now reduced;
    grep confirms zero bare display.clear() remain.
    [02_calibration_3point.py]
2026-06-01 Week_2 02_calibration: gc.collect() before font load to coalesce heap for 5280-byte font buffer (App-path contiguity)
    The font's XglcdFont loader does a single contiguous bytearray(5280)
    allocation. In isolation (USB, no BLE) it loads fine at ~93 KB free, but
    on the App path the live BLE/SLP/1 resident heap plus the fragmented
    import-time scratch leave no 5280-byte contiguous hole. A gc.collect()
    immediately before the load sweeps import-time garbage and coalesces the
    heap so the single block can be found.
    Follows the same defragment-before-heavy-alloc pattern already used
    between the ili9341/xglcd_font imports (commit 09620b6).
2026-06-25 Refactor Week_3: replace modular architecture with flat experiment.py/titration.py
    [01_flow_rate_calibration.py, 02_calibration_3point.py, experiment.py, main.py, titration.py]
2026-07-06 lib/xglcd_font: frozen-font-data fast path (F-186 parity with MicroPad frozen copy)
    Mirror of the SciLabPro MicroPad frozen-driver patch (decision 0080, F-186
    Component A) into the course-repo copy, per the F-187 course-copy sync ruling —
    the two are kept functionally identical.
    XglcdFont.__init__ tries __load_frozen_font(path) before the filesystem loader:
    it defensively `import xglcd_fonts_data` and, on a FONTS[basename] hit, serves
    glyphs via memoryview(<frozen bytes>) with no ~5,280 B bytearray allocation. On
    stock MicroPython (this course board) the frozen module is ABSENT -> ImportError
    -> the unchanged filesystem open(path)+bytearray loader runs. So the identical
    file works in both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
2026-07-06 lib/ili9341: fill_*/clear chunk cap ≤ max(512, one line) (F-187b parity with MicroPad frozen copy)
    Mirror of the SciLabPro MicroPad frozen-driver patch (decision 0087, F-187b) into
    the course-repo copy, per the F-187 course-copy sync ruling — kept functionally
    identical.
    One governing constant `_MAX_FILL_CHUNK_BYTES = 512` caps every clear/fill/blit
    chunk at max(1, 512 // (dim*2)) lines/cols, replacing the rdagger `1024 // dim`
    formula that built ~1920-2001 B contiguous chunks (MemoryError deep in a lesson
    on a fragmented arena). clear()'s cap supersedes its hlines arg. Applied to
    clear(), fill_hrect, fill_vrect, and draw_image. Pixel output byte-identical
    (chunking changes iteration co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
2026-07-07 Week_2 02_calibration: graceful Button-1 exit + one-line docstrings (App-path memory envelope on 4MB TitraLab)
    - Ending: 'Press Button 1 to exit' (debounced, clean exit code 0) replaces
    Ctrl+C-only exit; app stop_requested() path unchanged; KeyboardInterrupt
    kept as escape hatch. No more Thonny back-end noise after a clean finish.
    - Docstrings condensed to one-line summaries (~9 KB saved): the 66 KB file
    exceeded the MicroPad App run-path compile envelope on the 4 MB board;
    56 KB fits with margin. All printed teaching text is byte-identical.
    [02_calibration_3point.py]
2026-07-07 Week_2 02_Pump_Control: validators read /workspace/data/flow_calibration.txt
    02_pump_validate_continuous.py and 03_pump_validate_stepwise.py were reading
    a stale relative 'data_flowrate.txt' that 01_flow_rate_calibration.py never
    writes — the producer saves flow_rate= to the agreed persistent path
    /workspace/data/flow_calibration.txt. Both loaders now read that path;
    default-value fallback kept; tip messages name the real producer script.
2026-07-07 Week_3: rename main.py -> 01_titration_auto.py + 3 safety/UX fixes
    1. RENAME (critical): the lesson was named main.py, so importing Week_3
    placed it at /workspace/main.py — which the firmware auto-runs at EVERY
    boot, before the REPL banner. A long-blocking titration as the boot
    script makes the board appear to reboot forever and is how the field
    'continuous reboot' presented. The lesson is now an explicitly-run file;
    a NEVER-name-this-main.py warning is in the header. Docs updated
    (README / LAB_DIRECTION / USER_MANUAL, 19 references).
    2. SAFETY: wait_for_button timeout no longer auto-starts the titration
    (an actuator lesson must never start unattended); timeout now abo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
    [01_titration_auto.py]
2026-07-07 Week_3: silence buzzer immediately after construction
    ESP32 machine.PWM starts audible (~50% duty at default frequency) the
    moment it is constructed; the lesson creates the buzzer before the
    start-button wait, producing a long continuous beep until the first
    .off() (equivalence alert or cleanup). Call buzzer.off() right after
    construction. (Firmware follow-up queued: slp.buzzer helper should
    construct silent.)
    [01_titration_auto.py]
2026-07-07 Week_3: approaching-equivalence alert = 3 clear beeps
    A single 200 ms chirp after minutes of settle cycles is easy to miss
    over pump noise; the alert at ALERT_VOLUME_ML (4.8 mL) now beeps
    3 x 300 ms. (Note: on the pre-buzzer-fix file the constructor drone
    made this alert manifest as the sound STOPPING at 4.8 mL.)
    [01_titration_auto.py]
2026-07-07 Week_3: on-board TFT dashboard + bilingual console guidance
    The lesson was headless (no TFT, start prompt only as an app event).
    Now, using the proven Week_2 display pattern (release_tft -> SPI ->
    Display + flash-served XglcdFont), every phase shows on the board:
    - Splash: THIS board's calibration values (the students' own work)
    - READY screen: PRESS BUTTON 1 TO START (+ console prompt, Thai+En)
    - Live dashboard: big pH, volume, temp, step progress bar, status
    - NEAR EQUIV.PT! alert (with the 3 beeps) + console warning
    - COMPLETE screen: equivalence volume + unknown concentration
    - STOPPED screen on aborts ('Safe: pump OFF')
    All display ops are defensive (never raise -> chemistry never sto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
2026-07-07 Week_3: silence buzzer at import time (survivor-PWM kill)
    ESP32 LEDC PWM keeps running across script end and soft reset. A prior
    run stopped mid-beep (e.g. Stop pressed during the alert) leaves the
    buzzer sounding continuously into the NEXT run — and the in-function
    buzzer.off() only fired after the multi-second display init, so every
    start inherited seconds of screaming. The lesson now silences the
    buzzer pin as its very first action after imports.
    [01_titration_auto.py]
2026-07-07 Week_3: save titration data to /workspace/data/titration_data_RN.csv
    The refactored lesson only streamed points to the app and wrote no
    file on the board (the old course saved titration_data_R1.txt).
    Restore persistent data: every run now writes an auto-numbered CSV
    (volume_ml,pH,temp_c) with metadata comments (sample volume, titrant
    concentration, equivalence point, computed unknown concentration,
    completed/stopped flag). Saved on completion AND on user-stop
    (partial data is still lab data). The result event carries csv_path;
    students open/download the file from the app's data folder.
2026-07-07 Week_3: pre-flight battery reminder before the start prompt
    Field-diagnosed: the pump draws its starting current from the battery;
    on USB power alone every pump activation browns out the rail and the
    board reboots (the CP2102 de-enumerates mid-dose — the full-load
    titration exposed it once the battery left the bench). One console
    reminder saves a classroom hour.
    [01_titration_auto.py]
2026-07-07 Week_3: report volume at dose time + count delivered (not nominal) volume
    1. The first drop 'reported 0.0 mL': volume was streamed/printed/shown
    only AFTER the 10 s settle + sensor read, so the app/TFT/console kept
    showing the 0.0 baseline for ~11 s after each dose. The volume is
    deterministically known the moment the dose completes (closed-loop on
    time x flow) - stream it, print it, and update the TFT at dose time;
    pH/temp still follow after the settle ('Settling' -> 'Reading OK').
    2. Silent under-dosing fixed: if the calibrated flow is slow enough that
    the pump time clamps at DOSE_MAX_ON_MS, each step delivers LESS than
    DOSE_VOLUME_ML but the lesson counted the nominal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
    [01_titration_auto.py]
2026-07-07 Week_3: narrate the 0.0 mL baseline phase + coherent LED semantics
    1. The lesson silently spent its first seconds reading the 0.0 mL
    baseline (correct chemistry - every curve needs its starting point
    before any titrant), which looked like 'LED on, nothing happening'.
    It now announces the baseline read on console + TFT ('Baseline').
    2. LED semantics were self-contradictory: steady-on meant 'running'
    but dose_one_step ended every dose with led OFF, killing the running
    indicator from drop 1. Now: steady ON = running; a brief OFF-blink
    marks each dose (visible rhythm), restored to ON after.
    [01_titration_auto.py]
2026-07-08 Stop-flow pump calibration: two-stage model (continuous + stepwise fine-tune)
    Continuous calibration (01) amortizes the pump's start-up deficit (motor
    spin-up, tubing elasticity, firmware soft-start) over one long run, but
    stepwise titration pays it on EVERY burst -> ~0.4 mL cumulative shortfall
    measured by graduated cylinder. Two-parameter model: V(t) = flow*t - deficit.
    - NEW Week_2/02_Pump_Control/04_flow_stepwise_finetune.py: doses 20
    uncompensated bursts at the Week_3 titration profile via set_actuator
    (same drive path incl. soft-start), student enters the measured cylinder
    volume, computes+saves burst_deficit_ml to flow_calibration.txt
    (additive key, backward compatible; sanit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
    [01_titration_auto.py, 03_pump_validate_stepwise.py, 04_flow_stepwise_finetune.py, experiment.py, titration.py]
2026-07-08 Week_2 04 fine-tune: N_BURSTS 20 -> 25 (expected 5.0 mL) for better consistency
    25 bursts averages the per-start deficit over more samples and lands the
    expected volume on a clean 5.0 mL cylinder reading (matches 03's target).
2026-07-08 Week_2 01_basic_ph_read: BTN1 fix — replace Pin.irq with the proven polling pattern
    User-reported: BTN1 (GPIO34) works in 02_calibration_3point.py but not in
    01_basic_ph_read.py. 01 was the ONLY lesson using a GPIO interrupt
    (Pin.IRQ_FALLING); every working lesson (02/03/Week_3) polls the pin.
    Converted to the same active-low polling with falling-edge detection +
    300 ms debounce, main loop tightened 200 -> 50 ms so a human press is
    never missed (display updates stay throttled to ~200 ms; auto-stop
    latency improves). IRQ attach/detach removed.
    [01_basic_ph_read.py]
2026-07-08 Week_2 01_basic_ph_read: BTN1 polarity-agnostic press detection (idle-relative)
    Bench probe on TITRA-47E8 (fw 0.4.17, battery connected): GPIO34 idles LOW,
    press drives HIGH (active-high — matching Week_3's proven wait_for_button
    and its 'pull-down on board' note). The course comments claimed active-low;
    yesterday's polling patch inherited that assumption, so its first poll saw
    the assumed-idle-1 -> real-0 'edge' = a phantom press (recording started by
    itself), and every real press RELEASE then toggled again (stopping the
    recording within the first second -> time pinned at 0 s). machine.Timer(0)
    itself verified healthy on 0.4.17 (probe: 5 ticks/1.1 s).
    GPIO34 has no internal pulls; the id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
2026-07-08 Week_2 01_basic_ph_read: fix Time frozen at 0 s — replace machine.Timer with main-loop deadline sampling
    Field evidence (user, via the app): recording starts but Time stays 0 s;
    tapping Ctrl-C made it jump to exactly 8 s and stop. 8 = MicroPython's
    scheduler queue depth: machine.Timer soft callbacks are queued but never
    serviced while a lesson runs on the app path (further schedules dropped),
    then all 8 drain at the interrupt. Timer hardware itself verified healthy
    (REPL probe: 5 ticks/1.1 s on fw 0.4.17).
    Fix: drop machine.Timer entirely; the 1 Hz sample now runs from the
    lesson's own 50 ms main loop on a drift-free time.ticks_add deadline
    (record_data_sample). Same CSV, same display, sa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
    [01_basic_ph_read.py]
2026-07-08 Week_1 core: เพลงมหาจุฬาลงกรณ์ (first 2 lines) buzzer example
    Transcribed from the user's score (F major, 4/4, treble): staff-line/
    note-head positions measured from the sheet image and cross-checked
    against bar math (every bar sums to 4/4) and the tied whole notes.
    Teaches PWM frequency = musical pitch; melody as (freq, beats) data with
    one lyric syllable per note; ESP32 silent-at-construction PWM discipline;
    finally-block silence on Ctrl+C. Buzzer GPIO26 per pins.py.
    [ex_song_maha_chulalongkorn.py]
2026-08-05 Blocks section: example 01 — DS18B20 temperature on the TFT (guide + generated-code reference)
    New MicroPython/Blocks/ course area for the app's visual-Blocks page.
    01_ds18b20_tft.md: bilingual block-by-block assembly (Raw Python TFT setup
    -> Forever -> set temp = Read DS18B20 on GPIO16 -> Print value -> Raw
    Python TFT draw -> Sleep 1 s), hardware table (GPIO16 + 4.7k pull-up),
    Python-preview cross-check, troubleshooting (incl. the firmware's
    'no DS18B20 found on pin 16' error), and the teaching takeaways.
    01_ds18b20_tft_reference.py: the exact Python the blocks generate —
    bench-verified on TITRA fw 0.4.17: full TFT pipeline (release_tft, SPI,
    Display, frozen font, title draw) runs clean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
2026-08-05 Blocks example 01: simplified to 5 blocks — native TFT blocks, no Raw Python (primary-school)
    The app (1.3.1+40, A-208) now has native screen blocks (Show text / Show
    value / Clear — zero configuration, because the TitraLab TFT is fixed
    PCB hardware). The in-app Examples flagship becomes 5 simple blocks;
    the display setup is generated automatically and invisibly.
    01_ds18b20_tft_reference.py replaced with the NEW generated program —
    bench-verified on TITRA hardware with a live DS18B20 on GPIO16
    (25.9-26.0 C readings streaming, TFT title + value updating).
    Guide rewritten for load-from-gallery + the 5-block structure; Raw
    Python noted as an Advanced-category option for older students.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
2026-08-05 Blocks example 01: refresh reference for app +41 (decimals + free x/y screen blocks)
    Reference replaced with the A-209 generated flagship — bench-verified on
    TITRA hardware with live DS18B20 on GPIO16 (27.25-27.3 C streaming, TFT
    updating). Helper deltas vs +40: one drawing path (_tft_show_at with
    x 0..302 / y 0..210 clamps, x-derived truncation (320-x)//18, row N ==
    x=20 y=20+(N-1)*34 wrapper), decimals parameter (1/2/3). The new
    TFT-playground gallery example (two positions, 3 vs 1 decimals) also
    bench-verified clean. Guide gains the new-blocks section.
2026-08-08 Blocks example 4: pH Meter on TFT (calibration-first pedagogy)
    02_ph_tft_reference.py: the generated program verbatim (app 1.3.1+42,
    A-210/decision 0097) — 5 blocks, the Example-1 structure with
    slp.ph_probe(32).read() and 2-decimal display.
    Bench-verified on TITRA hardware 2026-07-10: the uncalibrated-board path
    fired exactly as designed — TFT drew the title, then
    RuntimeError('ph calibration missing for pin 32') — the program refuses
    to fabricate pH without this board's own stored calibration (Lab -> pH
    wizard). Guide frames the error as the lesson and documents both valid
    outcomes; per the freeze, a plausible pH on an uncalibrated board is the
    only failing outcome.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
